DrOnkel/DifDin/README.md

20170804
BuildInstruction1.pdf   Step-by-Step Instruction  "How to make Differential Dynamometr"

DifDin4_Nano_LED.JPG   Schematics of DifDyn with LED 4x4 Digit 7-element Display

DifDin4_Uno_LCD_Engl00.JPG Schematics of DifDyn with LCD 2x16 Display

DifDinLCD.ino  Arduino IDE code for DifDyn with LCD Display

DifDinLED.ino  Arduino IDE code for DifDyn with LED Display

DifDinRu.zip    - ZIPped files of screen visualizer for Win. Freeware

DifDyn4LED.spl7   Schematics of DifDyn with LED Display ifn SPlan 7.0 format

t2.hex    binary code for atmega 328 pu microcontroller for DidDyn with LED Display. Need no boot.
InstructionEng.pdf Instruction how to launch and work at PC Force Monitor. 
DifDyn4Engl.zip   Freeware, need no installation Monitor Program for Windows PC.

# DifDin
Differential Dynamometer for Stroke Rehabilitation
Code for Arduino IDE 
Schematics are in *.jpg format  and in Splan7 format
The version line
27.07. 2017  The initial Code. Fully completed and tested *.ino code for devise with LCD 2x20 display
Raw hex file for direct loading to atmega328pu microcontroller withour Arduino IDE boot is added.

Content 2017 07 27
DifDin4_Uno_LCD_Engl00.JPG   Device schematics in graphim view, english language titles and marks
DifDin4_Uno_LCD_Engl00.spl7   Device schematics in SPlan format, english language titles and marks
DifDinLCD.ino   code for Arduino IDE. Device with LCD 2x16 Display. GNU Licence
t2.hex   hex file for direct load to atmel atmega328pu microcontroller (in Arduino Nano), without boot sector
README.md this file
