DrOnkel/DifDin/DifDin4_Nano_LED.JPG

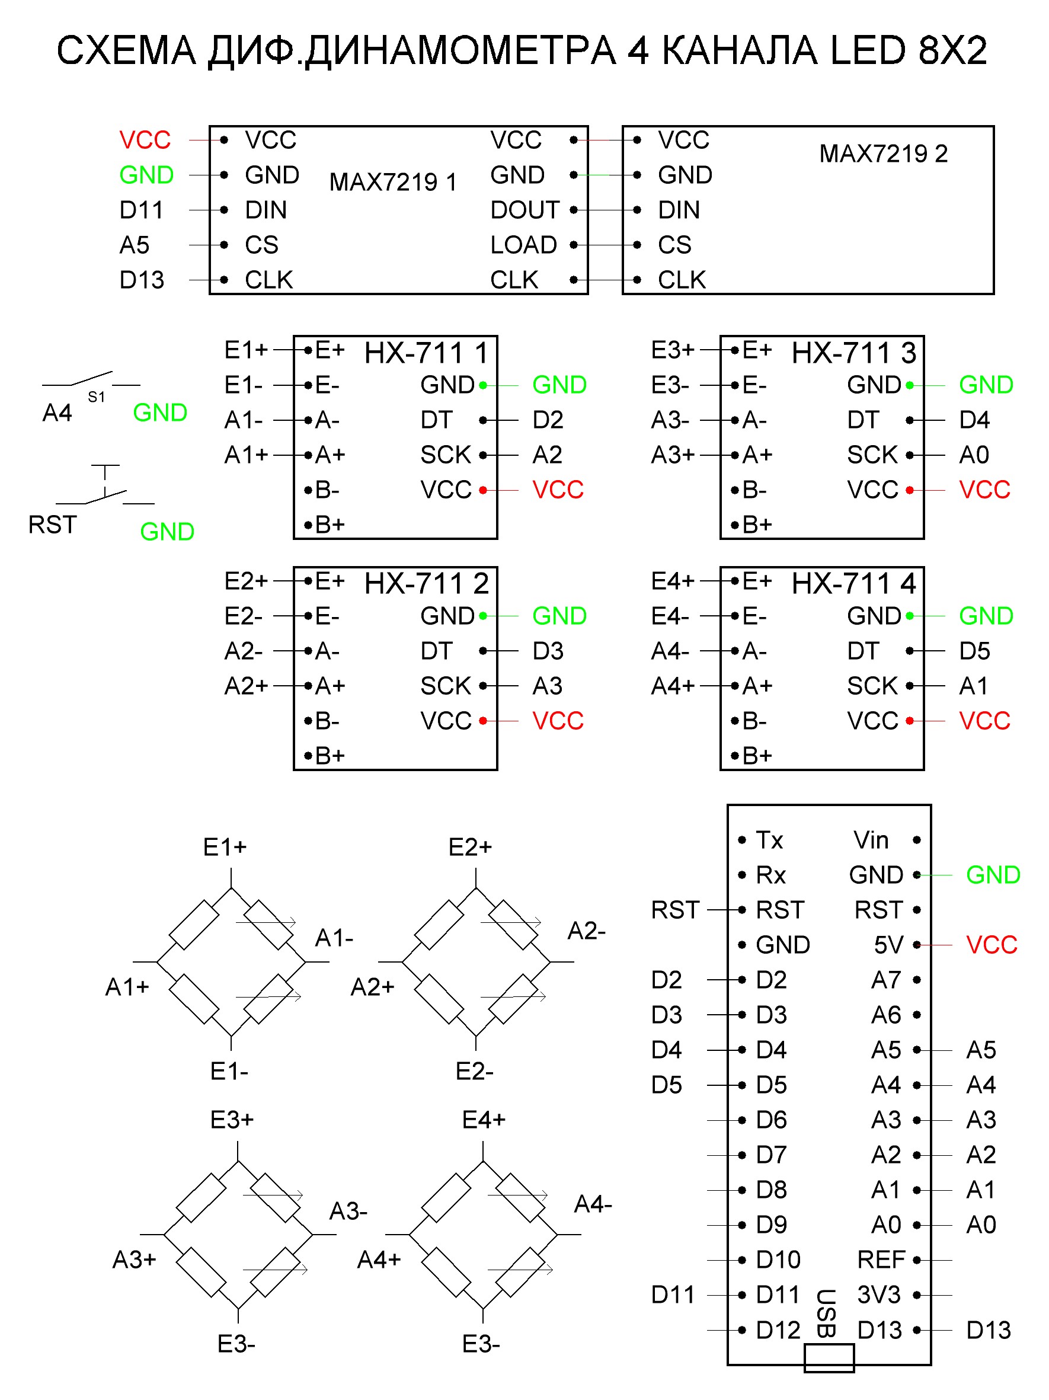
DifDin4_Nano_LED.JPG
