DrOnkel/DifDin/DifDin4_Uno_LCD_Engl00.JPG

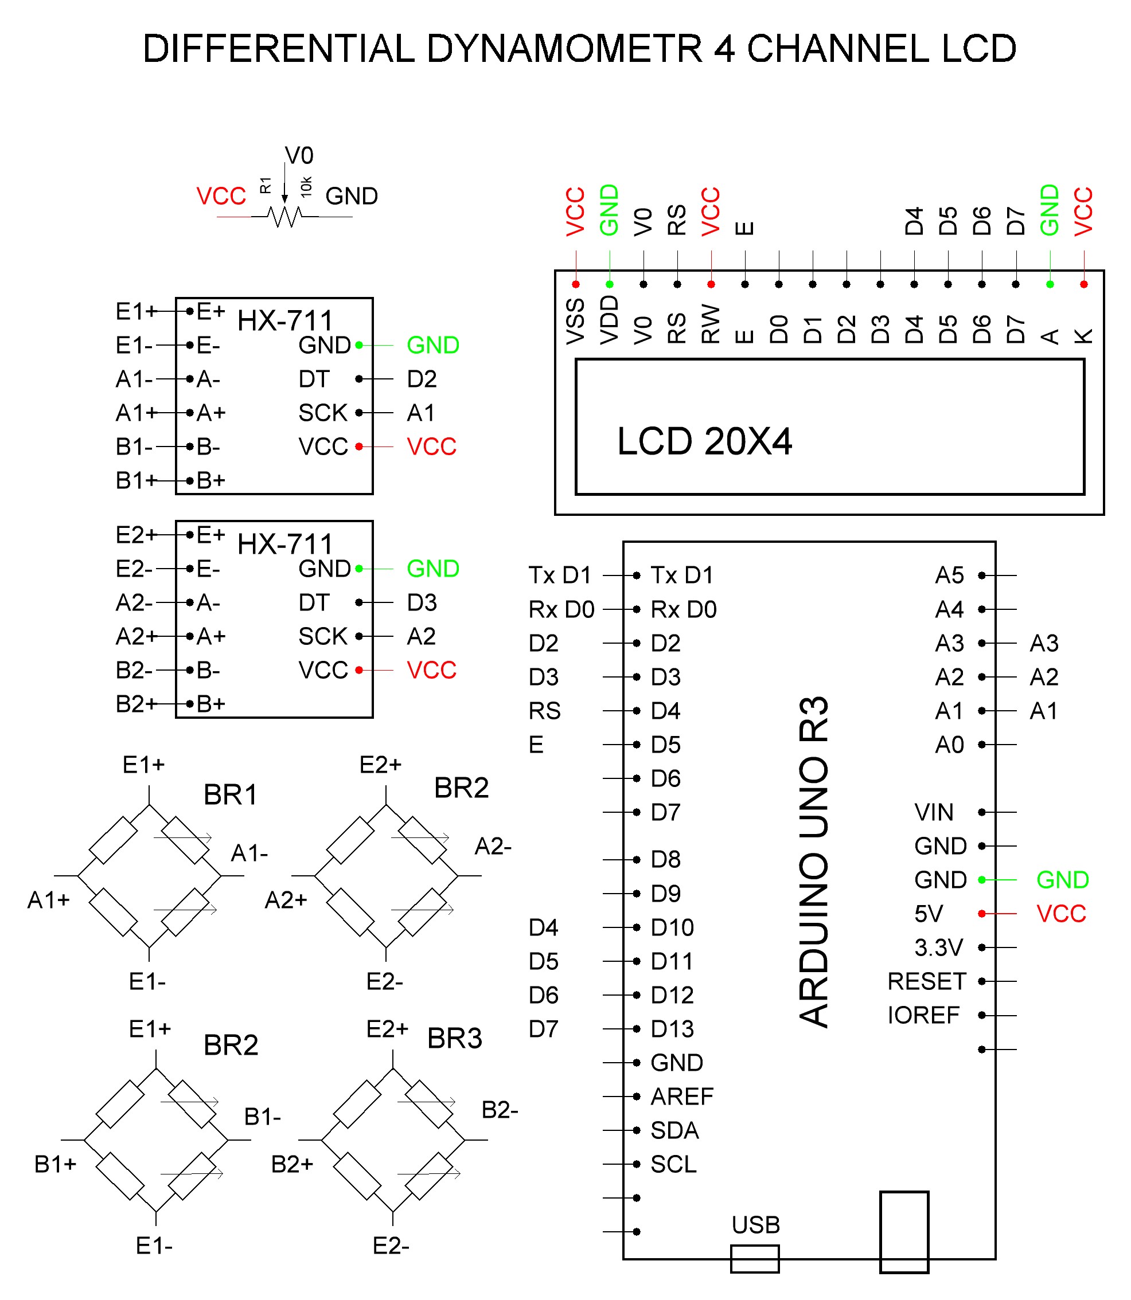
DifDin4_Uno_LCD_Engl00.JPG
