DrOnkel/DifDin/(list of files, drawings)

Other design files:
DifDyn4LED.spl7
