DrOnkel/DifDin/(commit log)

2017-07-27 New corrected version
    [DifDin4_Nano_LED_Engl02.spl7]
2017-08-03 *Led arduino code is added
    *Led arduino code is added
2017-08-03 *.ino code for LED
    *.ino code for LED
2017-08-04 SPlan schematics of DifDyn with LED
    SPlan schematics of DifDyn with LED
